OneWireHomeAutomation/VOC_sensor/voc_sensor.brd

## EAGLE design voc_sensor.brd (2016-08-24)

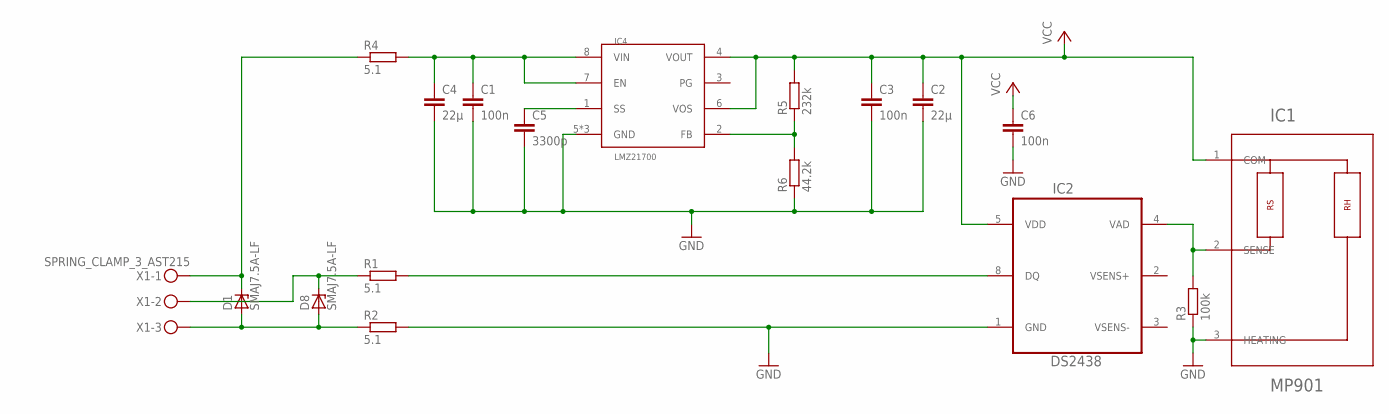
[picture p1: schematic voc_sensor.sch]

Parts:
C1, C3, C6: 100n; C0402
C2, C4: 22µ; C0805K
C5: 3300p; C0402
D1, D8: SMAJ7.5A-LF; DO214AC
IC1: MP901
IC2: DS2438; SO-08
IC4: LMZ21700
R1, R2, R4: 5.1; R0402
R3: 100k; R0402
R5: 232k; R0402
R6: 44.2k; R0402
X1: SPRING_CLAMP_3_AST215; AST215_3

Connections:
GND: C1.2, C2.2, C3.2, C4.2, C5.2, C6.2, IC1.3 (HEATING), IC2.1 (GND), IC4.5 (GND), IC4.TPAD@1 (GND), IC4.TPAD@2 (GND), R2.2, R3.1, R6.1
unnamed: IC1.2 (SENSE), IC2.4 (VAD), R3.2
unnamed: C1.1, C4.1, IC4.7 (EN), IC4.8 (VIN), R4.2
unnamed: D1.C, R4.1, X1.1A, X1.1B
unnamed: D1.A, D8.A, R2.1, X1.3A, X1.3B
unnamed: C5.1, IC4.1 (SS)
unnamed: IC4.2 (FB), R5.1, R6.2
unnamed: D8.C, R1.1, X1.2A, X1.2B
unnamed: IC2.8 (DQ), R1.2
VCC: C2.1, C3.1, C6.1, IC1.1 (COM), IC2.5 (VDD), IC4.4 (VOUT), IC4.6 (VOS), R5.2

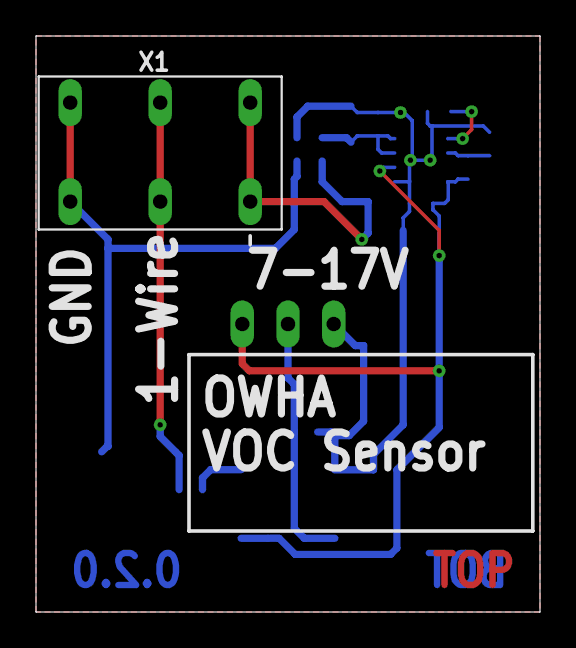
[picture p2: board voc_sensor.brd from above]

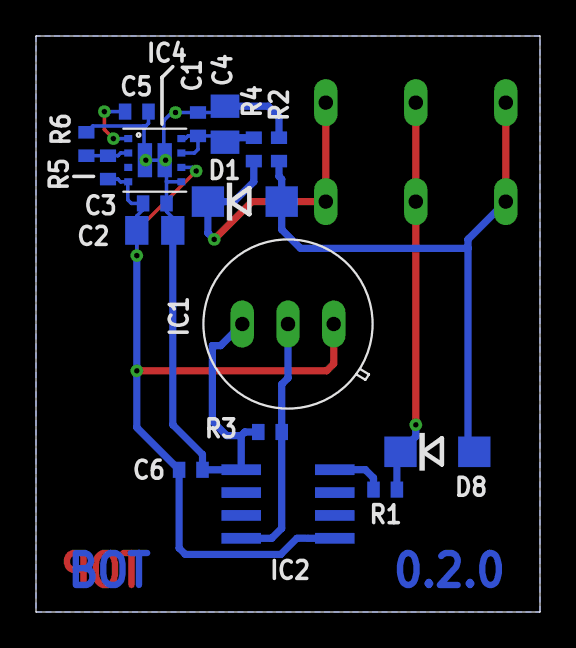
[picture p3: board voc_sensor.brd from below]

Board: 2 copper layers, 28.0 x 32.0 mm, 18 parts (17 on the bottom side), 10 nets.
