OneWireHomeAutomation/VOC_sensor/(threads)

Thread 1 (2016-06-26):

replace linear regulator with switching regulator

ch-aurich, 2016-06-26:
The VOC-sensor needs to be permanentlly heated via the 5V supply. Currently the board uses an 5V linear regulator to provide a stable 5V supply. It would be energetically better to have a switching regulator.

ch-aurich, 2016-09-15:
solved in 0.2.0

Closed 2016-09-15.

Thread 2 (2016-06-26):

connector on back too deep

ch-aurich, 2016-06-26:
The connector on the back is quite deep for usual wall inserts. There is almost no room to route the wiring to the connector. Better replace the connector with one that is lower profile.

Closed 2016-06-26.

Thread 3 (2016-09-15):

input protection (TVS) not working over input voltage range

ch-aurich, 2016-09-15:
The TVS diodes across the input are rated for 7.5V but the input is rated for 7-17V - this will not work of cause.

ch-aurich, 2016-09-15:
I would suggest to use SMAJ12A - this clamps the voltage to lower than 20V which is the max. input voltage of the voltage regulator. But it also would limit the input voltage range to 7-12V

Closed 2016-10-02.
