OneWireHomeAutomation/VOC_sensor/(commit log)

2016-06-07 adding first test of sensor PCB and schematic
    [voc_sensor.brd, voc_sensor.sch]
2016-06-10 changing some values: 5 Ohm resistor to 5.1 Ohm (5 Ohm is not broadly available) selected different type of TVS diode with essentially the same ratings
    [voc_sensor.brd, voc_sensor.sch]
2016-06-26 changing load resistor to 100k as stated on the sensor packaging... already tried this and it works like a charm
    [voc_sensor.brd, voc_sensor.sch]
2016-06-26 changing filename of BOM file in release.sh zip command
2016-06-26 replaced connector X1 to get a lower profile inside of the wall insert (resolves issue #2)
    [voc_sensor.brd, voc_sensor.sch]
2016-07-17 changing the 5V regulator to a switching type and adding some stuff to make the revision visible on the board without guesswork
    [voc_sensor.brd, voc_sensor.sch]
2016-08-24 moving clamping terminal to get out of the way of case parts and removing some DRC errors
    [voc_sensor.brd]
2016-08-24 making name and place layers pretty
    [voc_sensor.brd]
2016-08-24 further improving the placement print
    [voc_sensor.brd]
2016-08-24 changing PCB thickness
    [voc_sensor.brd]
